JonasSprocatti/Z-io/hardware/caixa-porteiro/previa/2-frente.png

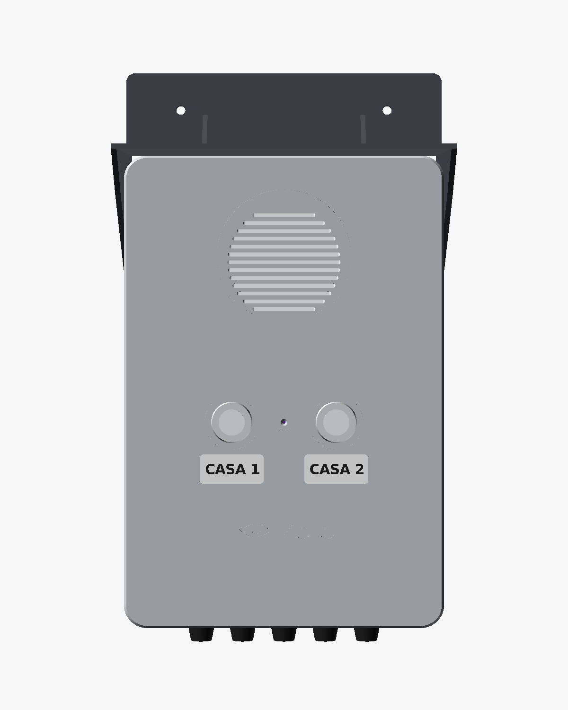
hardware/caixa-porteiro/previa/2-frente.png
