JonasSprocatti/Z-io/hardware/caixa-porteiro/stl/base.stl

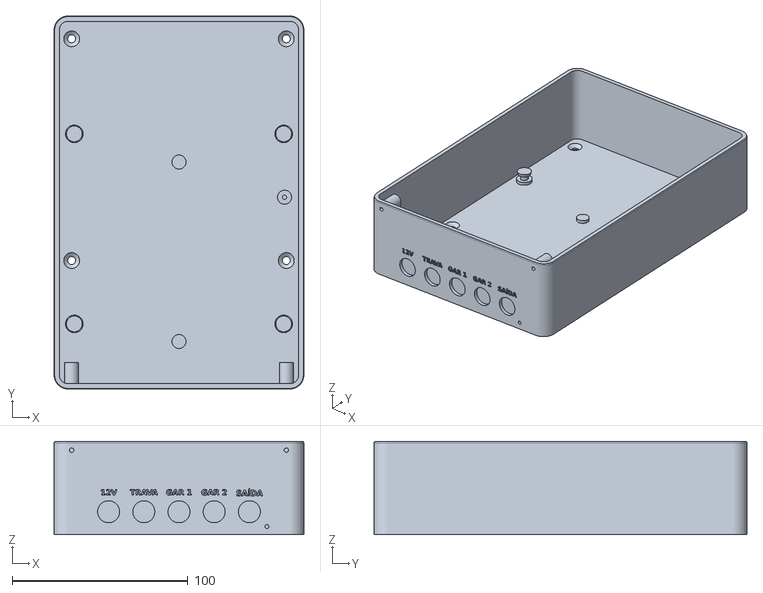
[picture p14: CAD file, 2026-11-10]
hardware/caixa-porteiro/stl/base.stl
142.0 x 212.0 x 53.0
