JonasSprocatti/Z-io/hardware/caixa-porteiro/stl/bandeja.stl

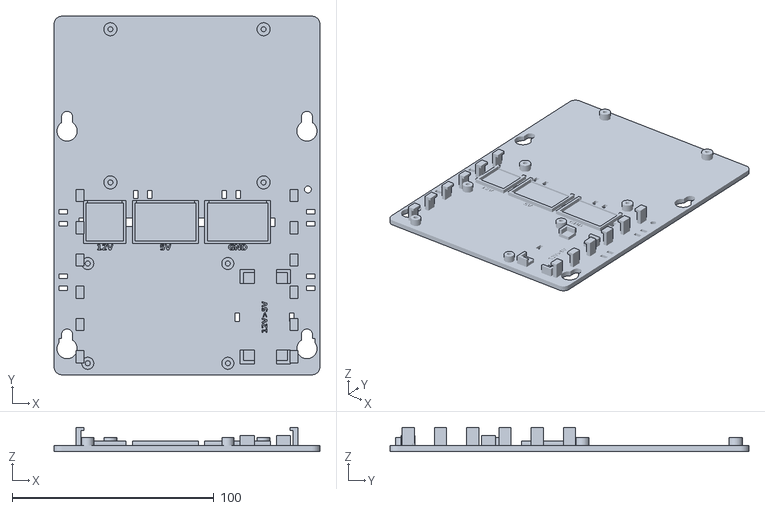
[picture p15: CAD file, 2026-11-10]
hardware/caixa-porteiro/stl/bandeja.stl
132.0 x 178.0 x 12.0
