JonasSprocatti/Z-io/hardware/caixa-porteiro/stl/tampa.stl

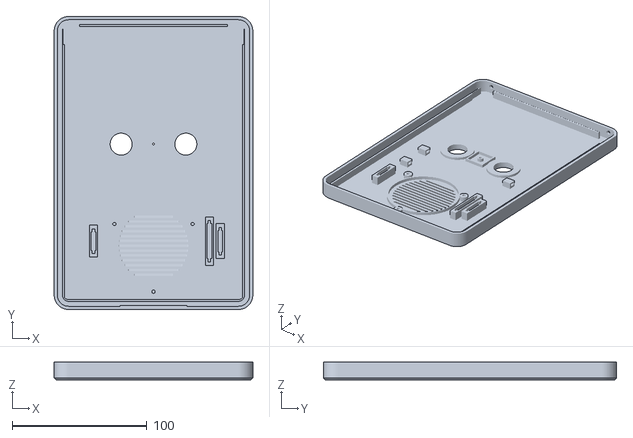
[picture p16: CAD file, 2026-11-10]
hardware/caixa-porteiro/stl/tampa.stl
147.4 x 217.4 x 13.0
