JonasSprocatti/Z-io/hardware/caixa-porteiro/stl/capa.stl

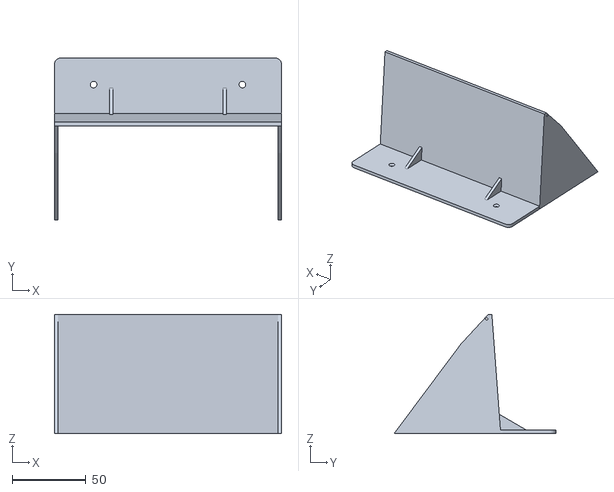
[picture p17: CAD file, 2026-11-10]
hardware/caixa-porteiro/stl/capa.stl
154.4 x 110.0 x 81.0
