JonasSprocatti/Z-io/hardware/caixa-porteiro/stl/anel.stl

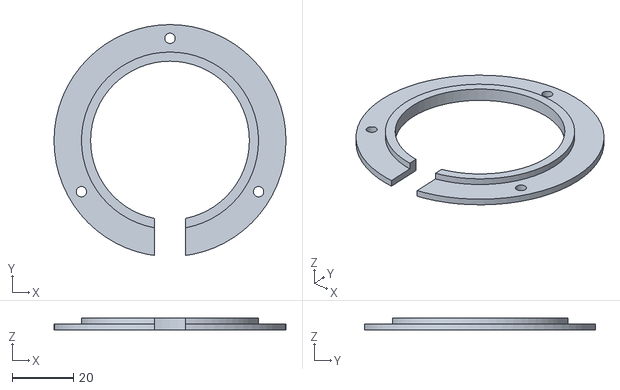
[picture p18: CAD file, 2026-11-10]
hardware/caixa-porteiro/stl/anel.stl
76.0 x 75.6 x 4.00
