JonasSprocatti/Z-io/deploy/esphome/porteiro.yaml

# Placa do porteiro do Zóio: ESP32-S3 no portão.
#
# Faz tudo o que fica no portão: campainha, conversa (microfone e
# alto-falante), fechadura do portão de pedestre e as duas garagens, com o
# estado aberta/fechada de cada uma.
#
# Ligação (ESP32-S3-DevKitC-1, tudo na fileira esquerda; esquema completo em
# docs/porteiro.md):
#   GPIO4, GPIO5, GPIO6  → microfone INMP441: SCK, WS, SD (L/R no GND, VDD no 3V3)
#   GPIO7, GPIO15, GPIO16 → amplificador MAX98357A: BCLK, LRC, DIN (VIN no 5V)
#   GPIO10 → IN1 do módulo relé: fechadura do portão
#   GPIO17 ← botão da campainha (o outro fio no GND)
#   GPIO18 ← botão da campainha da casa 2, se houver (o outro fio no GND)
#   GPIO21 ← botão de saída, do lado de dentro, se houver (o outro fio no GND)
#   GPIO8  ← DATA do receptor de rádio 433 MHz (RXB6, no 3V3), se houver
#   Garagens: veja o pacote escolhido em `packages:` no fim deste arquivo.
#
# Os nomes dos botões e sensores são os que o Zóio procura: não mude.
# Os nomes que aparecem no app ficam no zoio.env (ZOIO_GARAGE_NAMES).
#
# Segurança:
# - só a API nativa do ESPHome, cifrada com a chave (a mesma do ZOIO_GATE_KEY);
# - sem servidor web, sem atualização pela rede (OTA) e sem ponto de acesso de
#   emergência: ninguém por perto consegue reconfigurar ou regravar a placa.
#   Para atualizar, ela volta para o USB do Pi;
# - o tempo de cada pulso está gravado aqui: nenhum comando segura um relé ligado;
# - a conversa só liga o microfone quando o Zóio pede, com uma chave nova a
#   cada vez, e desliga sozinha sem sinal do Zóio ou depois do tempo máximo.
#
# Os segredos (Wi-Fi, chave e códigos de rádio) ficam num secrets.yaml gerado
# no Pi, fora do Git.

substitutions:
  rele_invertido: "true"  # a maioria dos módulos aciona com nível baixo
  pulso_portao: 1s        # quanto tempo a fechadura recebe energia
  pulso_garagem: 700ms    # quanto tempo a botoeira (ou o botão do controle extra) fica apertada
  sensor_invertido: "false"  # "true" se o sensor com fio fechar o contato com a garagem aberta
  ganho_microfone: "4"     # volume do microfone na conversa (1 a 64); aumente se ficar baixo
  volume_toque: "0.3"      # volume do "blim-blom" da campainha no alto-falante (0 a 1; 0 desliga)

esphome:
  name: zoio-porteiro
  friendly_name: Porteiro

esp32:
  board: esp32-s3-devkitc-1
  variant: esp32s3
  framework:
    type: esp-idf

logger:
  level: INFO

wifi:
  ssid: !secret wifi_ssid
  password: !secret wifi_password
  power_save_mode: none  # resposta rápida (a placa fica na tomada)

api:
  encryption:
    key: !secret api_key
  reboot_timeout: 0s  # sem o Zóio por perto, a placa continua de pé
  actions:
    # O Zóio chama estas duas ações para abrir e fechar a conversa.
    - action: conversa_iniciar
      variables:
        chave: string  # 16 bytes em hexadecimal, nova a cada conversa
      then:
        - lambda: "id(conversa).start(chave);"
    - action: conversa_parar
      then:
        - lambda: "id(conversa).stop();"

output:
  - platform: gpio
    id: rele_portao
    pin: { number: GPIO10, inverted: "${rele_invertido}" }

script:
  - id: pulso_portao
    mode: single  # apertos repetidos durante o pulso são ignorados
    then:
      - output.turn_on: rele_portao
      - delay: ${pulso_portao}
      - output.turn_off: rele_portao

button:
  - platform: template
    name: "Abrir portao"  # vira abrir_portao
    icon: mdi:gate-open
    on_press:
      - script.execute: pulso_portao

binary_sensor:
  - platform: gpio
    name: "Campainha"  # casa 1
    pin: { number: GPIO17, mode: { input: true, pullup: true }, inverted: true }
    filters:
      - delayed_on: 30ms   # ignora ruído no fio
      - delayed_off: 2s    # segura o "tocou" o bastante para chegar no Zóio
    on_press:  # quem apertou ouve que funcionou, mesmo sem o Pi
      - lambda: "id(conversa).chime(${volume_toque});"
  # Segunda casa: o Zóio avisa só os aparelhos marcados com ela (Ajustes ›
  # Aparelhos). Sem botão no GPIO18, fica quieta. Para uma casa só, apague.
  - platform: gpio
    name: "Campainha 2"  # vira campainha_2
    pin: { number: GPIO18, mode: { input: true, pullup: true }, inverted: true }
    filters:
      - delayed_on: 30ms
      - delayed_off: 2s
    on_press:
      - lambda: "id(conversa).chime(${volume_toque});"
  # Botão de saída, do lado de dentro: abre o portão na hora, aqui mesmo na
  # placa, então funciona sem o Pi e sem Wi-Fi. O Zóio registra em Alertas.
  # Instale onde não dê para alcançar pela grade do lado de fora.
  - platform: gpio
    name: "Botao saida"  # vira botao_saida
    pin: { number: GPIO21, mode: { input: true, pullup: true }, inverted: true }
    filters:
      - delayed_on: 50ms   # ignora ruído no fio
      - delayed_off: 1s
    on_press:
      - script.execute: pulso_portao

sensor:
  - platform: wifi_signal
    name: "Sinal Wi-Fi"  # o Zóio mostra em Ajustes: ajuda a saber se precisa de repetidor
    update_interval: 60s

# Conversa: microfone e alto-falante, cada um no seu barramento I2S.
external_components:
  - source: { type: local, path: components }
    components: [zoio_conversa]

i2s_audio:
  - id: i2s_microfone
    i2s_bclk_pin: GPIO4
    i2s_lrclk_pin: GPIO5
  - id: i2s_alto_falante
    i2s_bclk_pin: GPIO7
    i2s_lrclk_pin: GPIO15

microphone:
  - platform: i2s_audio
    id: microfone
    i2s_audio_id: i2s_microfone
    adc_type: external
    i2s_din_pin: GPIO6
    pdm: false
    channel: left  # L/R do INMP441 no GND
    sample_rate: 16000
    bits_per_sample: 32bit

speaker:
  - platform: i2s_audio
    id: alto_falante
    i2s_audio_id: i2s_alto_falante
    dac_type: external
    i2s_dout_pin: GPIO16
    channel: mono
    sample_rate: 16000
    bits_per_sample: 16bit

zoio_conversa:
  id: conversa
  microphone:
    microphone: microfone
    gain_factor: ${ganho_microfone}
  speaker: alto_falante
  port: 6054
  tempo_maximo: 10min

# Receptor de rádio 433 MHz (opcional). Escuta o controle das garagens, para
# aprender o código (`zoio portao radio` mostra o que chegar), e os sensores
# sem fio. Sem o receptor ligado, não atrapalha.
remote_receiver:
  id: radio_rx
  pin: { number: GPIO8, mode: { input: true, pulldown: true } }
  dump: rc_switch
  tolerance: 35%
  filter: 250us
  idle: 4ms

# Garagens: escolha uma linha de cada grupo.
packages:
  # Como a placa aciona as garagens:
  #   porteiro/garagens-rele.yaml  → relés 2 e 3, na botoeira da central ou
  #                                  nos botões de um controle extra (rolling code)
  #   porteiro/garagens-radio.yaml → transmissor 433 MHz com o código do controle
  #                                  (só controle de código fixo)
  garagens: !include porteiro/garagens-rele.yaml
  # Como o Zóio sabe se a garagem está aberta:
  #   porteiro/sensores-fio.yaml   → sensor magnético com fio
  #   porteiro/sensores-radio.yaml → sensor de abertura sem fio, 433 MHz
  sensores: !include porteiro/sensores-fio.yaml
