JonasSprocatti/Z-io/(commit log)

2026-10-27 Servidor do Zóio no Raspberry Pi e app web
    - go2rtc para o ao vivo (RTSP do DVR para MSE/HLS, sem recodificar)
    - Servidor Python (aiohttp) com proxy restrito do ao vivo, busca e
    download de gravações via DVRIP com remux para MP4, alarmes de
    movimento em tempo real e notificações Web Push
    - App web instalável (PWA): grade, tela cheia, gravações, alertas, ajustes
    - Acesso só pelo Tailscale (tailscale serve), com lista de usuários
    - Instalador e serviços systemd para o Pi
    - Testes com DVR e go2rtc simulados
    Claude-Session: https://claude.ai/code/session_01RMAEXbTmvq6TUTLt5X1h3T
2026-10-27 Aprovação de aparelhos: chave por aparelho, aprovação pelo código e revogação
    - Cada aparelho gera uma chave ECDSA P-256 não exportável (WebCrypto) e
    mostra um código curto (impressão digital da chave)
    - Aprovação digitando o código num aparelho administrador ou no Pi
    (`sudo zoio aparelhos aprovar CÓDIGO`); revogar derruba a sessão na hora
    - Entrada por desafio assinado de uso único e sessão em cookie HttpOnly,
    Secure, SameSite=Strict, guardada só como hash
    - Tudo fora da casca do app exige sessão; push só para aparelhos aprovados
    e aviso aos administradores quando alguém pede acesso
    - Content-Security-Policy restrita
    - docs/acesso-remoto.md com as opções Tail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
2026-10-27 zoio check: confere o relógio do DVR e testa o download de uma gravação
    O check agora mostra a hora do DVR ao lado da do Pi (para conferir fuso e
    horário de verão), a gravação mais recente encontrada e, com --baixar, baixa
    até 3 MB dela, desmonta o fluxo e converte para MP4. Falhas nos alarmes ou no
    download não interrompem o resto e fazem o comando sair com código 1.
    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
2026-10-27 Corrige nomes de câmera com espaço e o instalador travando no Tailscale
    - zoio.env: valores sem aspas valem até o fim da linha. Antes, o shlex
    cortava no primeiro espaço, e ZOIO_CHANNEL_NAMES=Câmera 1,Câmera 2,...
    virava só "Câmera" para a câmera 1.
    - install.sh: o 'tailscale serve' fica esperando quando o Serve ainda não
    foi liberado na conta. Agora tem timeout de 20 s e mostra o link de
    liberação, em vez de travar em silêncio.
    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
    [config.py]
2026-10-28 Portão: botão no app para abrir o portão (ESP32 + relé com ESPHome)
    - Cliente mínimo da API nativa do ESPHome (Noise_NNpsk0, ChaCha20-Poly1305),
    feito com cryptography, que lista os botões e aperta o do portão.
    - Permissão "portão" por aparelho, assinatura nova do aparelho a cada
    abertura, intervalo mínimo de 5 s e registro em Alertas com quem abriu e
    uma foto da câmera do portão. Os outros administradores recebem push.
    - Tela de abrir com o ao vivo da câmera do portão e botão de segurar.
    - `zoio portao chave|testar|abrir` e `zoio aparelhos portao CÓDIGO [--nao]`.
    - Firmware ESPHome da placa (sem OTA, sem página web, pulso fixo de 1 s).
    - docs/portao.md com peças, lig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
    [__main__.py, app.py, config.py, devices.py, esphome.py, push.py, store.py]
2026-10-28 Porteiro, parte 1: campainha, portão e garagens com estado no app
    A placa do portão passa a ser o porteiro do Zóio (ESP32-S3 com ESPHome):
    fechadura do portão, botoeira das duas garagens, sensor magnético de cada
    garagem, botão da campainha e o sinal do Wi-Fi.
    - Conexão sempre aberta com a placa: assina os estados, ping a cada 20 s,
    reconexão com espera crescente e portas guardadas para aparecer mesmo
    com a placa fora do ar.
    - Campainha: push urgente para os aparelhos com a permissão de portaria,
    foto da câmera do portão em Alertas e no máximo um aviso a cada 15 s.
    - Garagens: o servidor decide o que pode ser feito (fechar só com o sensor
    dizendo aberta, durante o movim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
2026-10-28 Porteiro: garagens também pelo rádio 433 MHz, e aprender o código pelo Zóio
    O firmware passa a ter pacotes para as garagens, escolhidos no fim do
    porteiro.yaml:
    - garagens-rele.yaml: relés 2 e 3 na botoeira da central ou nos botões de
    um controle extra (para controles rolling code);
    - garagens-radio.yaml: transmissor 433 MHz no GPIO9 com o código fixo do
    controle;
    - sensores-fio.yaml ou sensores-radio.yaml: sensor magnético com fio ou
    sensor de abertura 433 MHz que avisa abrir e fechar.
    O receptor 433 MHz (GPIO8) fica na base e escreve no log cada código que
    escuta. `zoio portao radio` assina o log da placa pela API e mostra cada
    código novo uma vez, para ir no secrets.yaml.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
    [__main__.py, esphome.py, porteiro.py, porteiro.yaml]
2026-10-28 Porteiro, parte 2: firmware da conversa (microfone, alto-falante e áudio cifrado)
    Componente externo zoio_conversa: o Zóio chama a ação conversa_iniciar com
    uma chave de 16 bytes nova a cada conversa, e a placa troca áudio com ele por
    UDP (porta 6054) cifrado com AES-128-GCM. PCM 16 bits, 16 kHz, mono.
    - Contador por pacote, nonce com a direção, cabeçalho autenticado; pacote
    repetido, fora de ordem ou de outra chave é descartado.
    - Sem cancelamento de eco: enquanto o alto-falante toca, o microfone não é
    mandado (estilo rádio).
    - Encerra sozinha sem sinal do Zóio por 6 s ou depois de 10 minutos.
    Microfone INMP441 nos GPIO4/5/6 e amplificador MAX98357A nos GPIO7/15/16,
    cada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
2026-10-28 Porteiro, parte 2: conversa com o portão pelo app (segure para falar)
    Ponte no Pi entre o app e a placa:
    - esphome.py: lista as ações da placa (ListEntitiesServices) e roda uma
    ação com argumentos de texto (ExecuteService), confirmada por um Ping.
    - conversa.py: o lado do Zóio do áudio UDP com AES-128-GCM, chave nova a
    cada conversa, "estou aqui" a cada segundo, fim por silêncio, tempo
    máximo e limite de 2x o tempo real para o que vem do app.
    - porteiro.py: start_call e end_call. Uma conversa por vez (o portão é
    reservado antes de qualquer espera); quem tenta junto recebe "Fulano já
    está falando com o portão". No fim, conversa_parar pela API e evento
    Conversa com a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
2026-10-28 Visual novo do app: logo junto com o nome, ícones e telas mais caprichadas
    - Topo com a logo do Zóio ao lado do nome; a bolinha de estado fica no canto da logo
    - Tela de abertura com a logo enquanto o app carrega
    - Tela de aprovação com a logo grande e o código em destaque
    - Abas com ícones (no computador largo elas sobem para o topo)
    - Câmeras com a marca apagada enquanto o vídeo carrega, nome sobre degradê e selo de movimento
    - Alertas, gravações e aparelhos com ícone colorido por tipo
    - Cartões de Ajustes com ícone, botões e Portaria refinados
    - Versão 0.5.1; cache do service worker renovado
    Claude-Session: https://c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
2026-10-28 Ajustes › Câmeras: trocar o nome e ocultar câmeras pelo app
    O administrador troca o nome de cada câmera e esconde os canais sem
    câmera. Fica salvo no Pi e vale para todos os aparelhos na hora (aviso
    pelo fluxo de eventos). Câmera oculta some do ao vivo, das gravações e
    dos alertas, e não gera alerta nem notificação. Nome vazio volta ao do
    zoio.env. Versão 0.6.0.
    Claude-Session: https://claude.ai/code/session_01RMAEXbdiDwNKefsoKHT3pf
2026-10-28 Tira a bolinha cinza do canto das câmeras
    O player do go2rtc tem um <div class="status"> (onde escreve o erro) e o
    estilo da bolinha de estado do topo pegava nele também, desenhando um ponto
    no canto de cada câmera. O estilo agora vale só para a bolinha da logo.
    Versão 0.6.1; cache do service worker zoio-v8.
    Claude-Session: https://claude.ai/code/session_01RMAEXcByCH3eyjUj7eY1m6
2026-10-29 Reconhece os botões da placa com o ESPHome 2026
    Desde 2026 o ESPHome manda o object_id vazio na lista de entidades e cada
    cliente calcula pelo nome (snake_case + sanitize). O Zóio procurava pelo
    object_id e achava "nenhum" botão na placa real. Agora calcula pelo nome
    quando ele vem vazio, com a mesma regra do ESPHome.
    O sensor "Sinal Wi-Fi" vira sinal_wi-fi (o hífen fica), não sinal_wifi.
    A placa simulada dos testes passa a mandar o object_id vazio, como a real.
    Versão 0.6.2.
    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
2026-10-29 Imagem na proporção certa (16:9) e tela cheia na horizontal
    O DVR manda a imagem "espremida": o secundário vem em 352x240 e os canais
    em 1080N vêm em 960x1080 (mais alto que largo), mas as câmeras são 16:9.
    O app mostrava do jeito que chegava, então a imagem ficava achatada e,
    nas gravações, em pé.
    - As caixas de vídeo (grade, câmera, gravação, portaria) e as fotos têm a
    proporção do servidor e o vídeo estica até ela.
    - Nova opção ZOIO_VIDEO_ASPECT (padrão 16:9; `original` desliga), enviada
    em /api/config.
    - O MP4 baixado do DVR sai marcado com a proporção (-aspect, sem
    recodificar), então o VLC e o celular também mostram certo.
    - Botão de tela cheia na câm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
2026-10-29 Caixa do porteiro para impressão 3D
    Modelo paramétrico em OpenSCAD com base, bandeja removível, tampa de
    porteiro (grade inclinada do alto-falante, microfone e botão), anel do
    alto-falante e aba de chuva. Inclui os STLs, imagens de prévia e o guia
    de impressão e montagem.
    Claude-Session: https://claude.ai/code/session_01RMAEXemkkEskT72T7YVKF9
    [anel.stl, bandeja.stl, base.stl, capa.stl, porteiro_caixa.scad, tampa.stl]
2026-10-30 Caixa do porteiro: 2 botões de 16 mm com etiqueta
    Botão de pulso inox antivandalismo de 16 mm (rosca M16, corpo de até
    28 mm), um por casa, em coluna com um rebaixo para etiqueta ao lado.
    O microfone passa para a esquerda dos botões.
    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
    [porteiro_caixa.scad, tampa.stl]
2026-10-30 Campainha para duas casas
    Um segundo botão de campainha no GPIO18 ("Campainha 2", campainha_2). Com
    mais de uma campainha, cada toque leva o nome da casa (ZOIO_BELL_NAMES,
    padrão "Casa 1", "Casa 2") no aviso, em Alertas e na portaria.
    Em Ajustes › Aparelhos, o administrador escolhe de qual casa cada aparelho
    recebe a campainha (ou de todas, o padrão). A notificação vai só para os
    aparelhos daquela casa e os sem casa, e a portaria só abre sozinha no
    aparelho da casa que tocou. Cada casa tem o seu intervalo de 15 s, para um
    toque não engolir o da outra.
    Coluna nova devices.house (vazia: todas), API POST /api/devices/{id}/house.
    Versão 0.6.4.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
2026-10-30 Botão de saída do lado de dentro abre o portão
    Um botão no GPIO21 ("Botao saida", botao_saida) abre o portão direto na
    placa, pelo mesmo pulso da fechadura: funciona sem o Pi e sem Wi-Fi. O
    Zóio só registra a abertura em Alertas ("por botão de dentro", com foto),
    sem notificação, e junta apertos seguidos num registro só.
    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
2026-10-30 Campainha toca um "blim-blom" no alto-falante do portão
    Quem aperta a campainha ouve na hora que funcionou: a placa toca duas
    notas curtas no alto-falante da conversa. É a própria placa que gera o
    som, então funciona sem o Pi e sem Wi-Fi. Não toca durante uma conversa,
    e uma conversa que começa corta o toque. Volume em volume_toque no topo
    do porteiro.yaml (0 a 1, padrão 0.3; 0 desliga).
    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
2026-10-30 Notificações: tenta de novo e explica o erro do serviço de push
    Claude-Session: https://claude.ai/code/session_01RMAEXaesthPXQ8outz8tFr
2026-10-30 README completo: instalação, app, notificações, porteiro, firmware e caixa
    Reescreve o README cobrindo tudo o que existe no projeto, com sumário,
    tabela de configuração, comandos, problemas comuns e capturas do app
    (docs/imagens).
    Claude-Session: https://claude.ai/code/session_01RMAEXc6bjEjKmLYV4gUy9j
2026-11-10 Caixa do porteiro: placa de extensão de 83 x 83 mm
    A placa V2775 medida tem 83 x 83 mm (a caixa supunha 83 x 63). A bandeja
    foi reorganizada: relé e regulador lado a lado embaixo, os 3 Wago numa
    fileira no meio e a placa de extensão em cima. A caixa ficou 2 cm mais
    larga (147 x 217 x 57 mm) e continua cabendo numa mesa de 22 cm.
    Na frente, os 2 botões ficam lado a lado com o microfone no meio e a
    etiqueta embaixo de cada um. Alto-falante de 57 mm (4 ohms, 3 W).
    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
    [anel.stl, bandeja.stl, base.stl, capa.stl, porteiro_caixa.scad, tampa.stl]
2026-11-10 Caixa do porteiro: prensa-cabo para o botão de saída
    O botão que abre o portão por dentro fica do lado de dentro do portão,
    não na caixa. A base ganha um 5º prensa-cabo, marcado SAÍDA, para o cabo
    de 2 vias dele (IO21 e GND).
    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
    [base.stl, porteiro_caixa.scad]
